stephdust/ESP32-PoolMaster-SD/docs/InsideBox.png

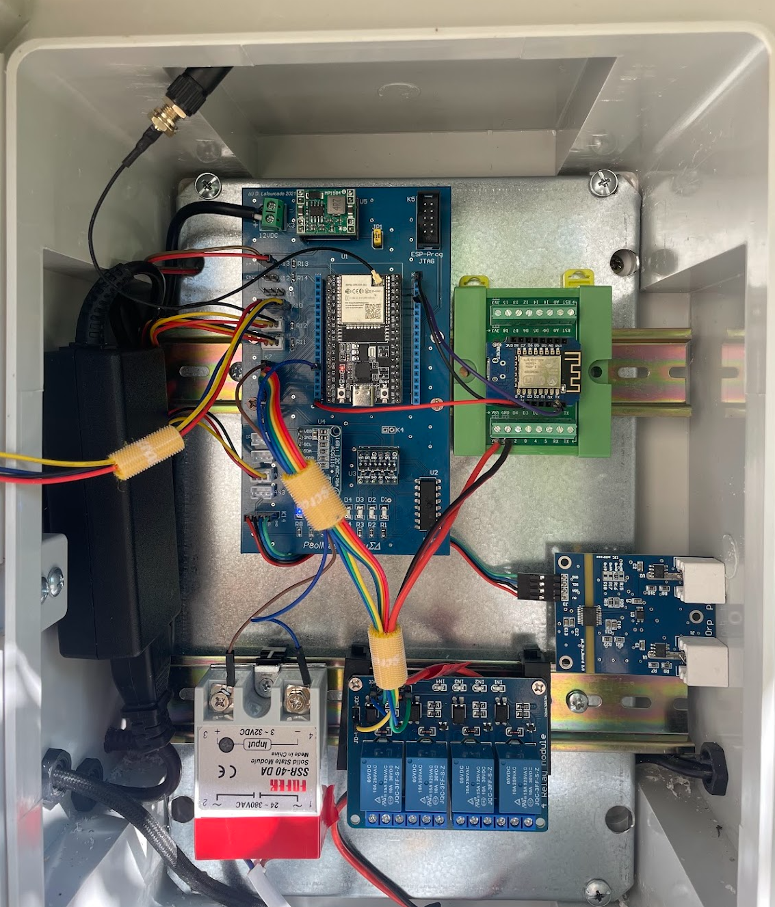
docs/InsideBox.png
