stephdust/ESP32-PoolMaster-SD/Nextion/PoolMaster_Nextion_V5.0/Page_Home.png

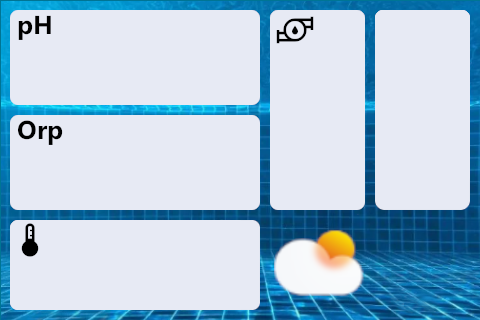
Nextion/PoolMaster_Nextion_V5.0/Page_Home.png
