stephdust/ESP32-PoolMaster-SD/Nextion/PoolMaster_Nextion_V5.0/Page_Settings_INACTIVE.png

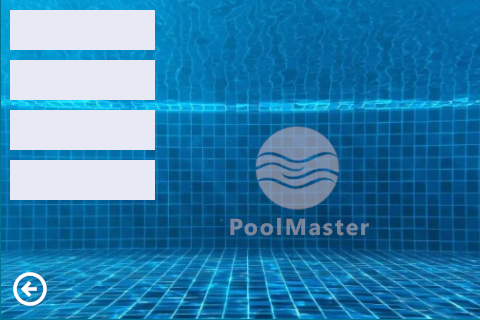
Nextion/PoolMaster_Nextion_V5.0/Page_Settings_INACTIVE.png
