stephdust/ESP32-PoolMaster-SD/PCB/Bill of Materials-PoolMaster.xlsx

Comment | Description | Designator | Footprint | LibRef | Quantity
HEADER 3 |  | AN0, AN1, AN2, AN3 | JST-1X3 | HEADER 3 | 4
100n | Capacitor | C1 | 0805C-GENERIC | CAP | 1
Red |  | D1, D2, D3, D4 | TOPLED-RED | LED | 4
Green |  | D5, D6 | TOPLED-GREEN | LED | 2
Yellow |  | D7 | TOPLED-YELLOW | LED | 1
Blue |  | D8 | TOPLED-BLUE | LED | 1
U/L | Jumper | JP1 | 2_PADS | JUMPER | 1
Header 19 | Header, 19-Pin | K1, K2 | HDR1X19 | Header 19 | 2
12VDC | Header, 2-Pin | K3 | MKDS15_2RMI | Header 2 | 1
I2C | Header, 2-Pin | K4 | HEADER-1X2 | Header 2 | 1
ESP-Prog/JTAG | Header, 5-Pin, Dual row | K5 | HE10_10 | Header 5X2 | 1
HEADER 3 |  | K6 | HEADER-1X3 | HEADER 3 | 1
HEADER 6 |  | K7 | HEADER-1X6 | HEADER 6 | 1
Air T | Header, 3-Pin | K8 | JST-1X3 | Header 3 | 1
Water T | Header, 3-Pin | K9 | JST-1X3 | Header 3 | 1
Display | Header, 4-Pin | K10 | HEADER-1X4 | Header 4 | 1
Buzzer | Header, 3-Pin | K11 | HEADER-1X3 | Header 3 | 1
Chl LVL | Header, 2-Pin | K12 | HEADER-1X2 | Header 2 | 1
pH LVL | Header, 2-Pin | K13 | HEADER-1X2 | Header 2 | 1
I2C-5V | Header, 4-Pin | K14 | HEADER-1X4 | Header 4 | 1
3k3 | Resistor | R1, R2, R3, R4, R5, R6, R7, R8 | 0805R-3K3 | RES2 | 8
10k | Resistor | R11, R12, R13, R14 | 0805R-10K | RES2 | 4
ESP32-DEVKITC-32E | - Transceiver; 802.11 b/g/n _Wi-Fi, WiFi, WLAN_, BluetoothÂ® Smart Ready 4.x Dual Mode For Use With ESP-WROOM-32 | U1 | MODULE_ESP32-DEVKITC-32D | ESP32-DEVKITC-32D | 1
PCF8574AN | Remote 8-Bit I/O Expander for I2C-Bus, 2.5 to 6 V, -40 to 85 degC, 16-pin PDIP (N), Pb-Free (RoHS) | U2 | DIP16 | PCF8574AN | 1
SHIFTER 4CH |  | U3 | SHIFTER 4CH | SHIFTER 4CH | 1
ADS1115 |  | U4 | ADS1115 Module | ADS1115 | 1
MP1584EN |  | U5 | MP1884EN | MP1584EN | 1
