stephdust/ESP32-PoolMaster-SD/PCB/BOM.xlsx

Sheet: Feuil1
Objet | lien | Prix Unitaire | Quantité | Prix Total
1 Alimentation MeanWell 12V HDR-30 | https://fr.aliexpress.com/item/4000512714343.html?spm=a2g0s.9042311.0.0.27426c372DwVi7 | 16 | 1 | 16
1 carte fille mega 2560 DIY + connecteur |  | 5 | 1 | 5
cables dupont 30cm | https://fr.aliexpress.com/item/32987024879.html?spm=a2g0s.9042311.0.0.6d836c373sh99I | 3 | 2 | 6
cable PH2.0 dupont | https://fr.aliexpress.com/item/4000983636722.html?spm=a2g0s.9042311.0.0.6d836c373sh99I | 5 | 1 | 5
mega2560 R3 Advanced Keyestudio | https://fr.aliexpress.com/item/32902050141.html?spm=a2g0s.9042311.0.0.27426c37zPn488 | 13 | 1 | 13
W5100 Ethernet Shield Keyestudio | https://fr.aliexpress.com/item/2042247327.html?spm=a2g0s.9042311.0.0.27426c37zPn488 | 8 | 1 | 8
Nextion bordure 6 | https://fr.aliexpress.com/item/4000127982680.html?spm=a2g0s.9042311.0.0.27426c37zPn488 | 6 | 1 | 6
Nextion NX4832K035 | https://fr.aliexpress.com/item/4000127982680.html?spm=a2g0s.9042311.0.0.27426c37zPn488 | 33.59 | 1 | 33.59
DS3231 Clock | https://fr.aliexpress.com/item/33000531103.html?spm=a2g0s.9042311.0.0.27426c37PumqU7 | 3 | 1 | 3
Support Rail DIN plastique | https://fr.aliexpress.com/item/4000539460290.html?spm=a2g0s.9042311.0.0.27426c37PumqU7 | 1.37 | 1 | 1.37
Relay shield | https://fr.aliexpress.com/item/33050594625.html?spm=a2g0s.9042311.0.0.27426c37PumqU7 | 5.7 | 1 | 5.7
Rail din 20cm | https://fr.aliexpress.com/item/32903957266.html?spm=a2g0s.9042311.0.0.27426c3755H1y5 | 2 | 2 | 4
sonde pression | https://fr.aliexpress.com/item/32851667666.html?spm=a2g0s.9042311.0.0.27426c3755H1y5 | 11 | 1 | 11
Connecteur RJ45 | https://fr.aliexpress.com/item/32901871650.html?spm=a2g0s.9042311.0.0.27426c37qMQp8c | 7 | 1 | 6
boitier legrand Marina | ebay | 60 | 1 | 60
tole galvanisé 300x200 | ebay | 11 | 1 | 11
pompe peristatique PR4 SEKO | ebay | 130 | 2 | 260
sonde PH Hanna |  | 70 | 1 | 70
Sonde ORP |  | 70 | 1 | 70
sonde temperature DS18B20 | https://fr.aliexpress.com/item/32983291667.html | 7.54 | 1 | 7.54
Module d'isolation de signal DFR0504 | https://www.gotronic.fr/art-module-d-isolation-de-signal-dfr0504-27832.htm | 21.9 | 2 | 44
Adaptateur pH/ORP 1130 | https://www.gotronic.fr/art-adaptateur-ph-orp-1130-12112.htm | 30.5 | 2 | 71
2 Relay de puissance 2P 25A 2NO 220V | https://fr.aliexpress.com/item/4000198627842.html?spm=a2g0s.9042311.0.0.27426c37qVlc3P | 6.68 | 2 | 13
(commande Lumiere + electrovanne )
Disjoncteur C2 |  | 15 | 1 | 15
1 kit mise à la terre poolterre |  | 50 | 1 | 50
accessoires divers |  | 20 | 1 | 20
 |  |  | total | 815.2

Sheet: Feuil2
Water pressure probe 500 kPa (5 bar) | https://fr.aliexpress.com/item/32851667666.html?spm=a2g0s.9042311.0.0.221a6c37pnW82C | 10.54 €
Power supply 12V-2A Meanwell | https://fr.aliexpress.com/item/4000512714343.html?spm=a2g0s.9042311.0.0.221a6c37pnW82C | 16.58 €
T 1/4" pipe connector | https://fr.aliexpress.com/item/4000195262654.html?spm=a2g0s.9042311.0.0.221a6c37pnW82C | 3.78 €
DIN rail alu 2x25cm | https://fr.aliexpress.com/item/4000126680453.html?spm=a2g0s.9042311.0.0.221a6c37pnW82C | 3.82 €
5x2 PCB DIN supports | https://fr.aliexpress.com/item/4000505427059.html?spm=a2g0s.9042311.0.0.221a6c37pnW82C | 4.83 €
Active Buzzer x3 | https://fr.aliexpress.com/item/32849730395.html?spm=a2g0s.9042311.0.0.221a6c37pnW82C | 1.66 €
Bidirectionnal Level Shifter | https://fr.aliexpress.com/item/32849730395.html?spm=a2g0s.9042311.0.0.221a6c37pnW82C | 0.20 € | note: use small diameter header pins (PCB has small holes)
6x5V relays module | https://fr.aliexpress.com/item/32649659086.html?spm=a2g0s.9042311.0.0.221a6c37pnW82C | 5.24 €
ADC 4 chanels 16bits | https://fr.aliexpress.com/item/32817162654.html?spm=a2g0s.9042311.0.0.221a6c37pnW82C | 1.82 €
ESP32-DevKitC-32E (V4) | https://fr.aliexpress.com/item/4001283141906.html?spm=a2g0s.9042311.0.0.221a6c37pnW82C | 10.13 €
LEDs 1206 5x100pc | https://fr.aliexpress.com/item/4000927747306.html?spm=a2g0s.9042311.0.0.27426c37BAGaMu | 1.91 €
Air temperature probe - DS18B20 3m | https://fr.aliexpress.com/item/4000895660165.html?spm=a2g0s.9042311.0.0.27426c37BAGaMu | 1.62 €
JST connectors | JST-1x3 M (2 mm pitch)
All resistors and capacitors | Size 0805
Converter DC-DC LM2596 x5 | https://fr.aliexpress.com/item/32531438467.html?spm=a2g0s.9042311.0.0.1ec66c37Lne6Zz | 4.03 € | note: use small diameter header pins (PCB has small holes)
Nextion display frame | https://fr.aliexpress.com/item/4000127982680.html?spm=a2g0s.9042311.0.0.1ec66c37Lne6Zz | 5.60 €
Display Nextion Enhanced NX4832K035 | https://www.banggood.com/fr/Nextion-Enhanced-NX4832K035-3_5-Inch-HMI-Intelligent-Smart-USART-UART-Serial-Touch-Screen-TFT-LCD-Module-p-1188732.html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 | 30.42 €
Amplifier pH-ORP 1130 x2 | https://www.gotronic.fr/art-adaptateur-ph-orp-1130-12112.htm | 109.30 €
Signal isolation module DFR0504 x2 | https://www.gotronic.fr/art-module-d-isolation-de-signal-dfr0504-27832.htm
Microdos pH probe | https://www.my-pool-covers.com/fr/regulation-chloreph/77-sonde-ph-dosage-automatique-piscine.html | 60.00 €
Microdos Redox probe | https://www.my-pool-covers.com/fr/regulation-chloreph/78-sonde-ph-dosage-automatique-piscine.html | 66.55 €
Analyze room (double) | https://www.my-pool-covers.com/fr/home/81-chambre-d-analyse-pour-sonde-ph-ou-redox.html | 129.00 €
Chlorine calibration solution 650mV | https://www.my-pool-covers.com/fr/accessoires-dosage/105-solution-etalon-pour-calibration-chlore-650-mv.html | 9.50 €
Chlorine calibration solution 468mV | https://www.my-pool-covers.com/fr/accessoires-dosage/106-solution-etalon-pour-calibration-chlore-468-mv.html | 9.50 €
pH calibration solution pH 7 | https://www.my-pool-covers.com/fr/accessoires-dosage/107-solution-etalon-pour-calibration-ph-7.html | 8.00 €
pH calibration solution pH 4 | https://www.my-pool-covers.com/fr/accessoires-dosage/108-solution-etalon-pour-calibration-ph-4.html | 8.00 €
Support collar 50mm 1/2" x2 | https://www.my-pool-covers.com/fr/regulation-chloreph/119-collier-de-prise-en-charge-50mm.html | 19.00 €
Pool grounding 50mm | https://www.my-pool-covers.com/fr/regulation-chloreph/121-pool-terre-50mm.html | 34.50 €
Microdos peristaltic pump 1,5l/h x2 | https://www.my-pool-covers.com/fr/regulation-chloreph/149-pompe-doseuse-peristaltique-avec-reglage-de-debit-15lh.html | 176.00 €
ABS case 350x250x150mm | https://www.amazon.fr/gp/product/B07C7X9K5R/ref=ppx_yo_dt_b_asin_title_o00_s00?ie=UTF8&psc=1 | 41.45 €
 |  | 772.98 €
