stephdust/ESP32-PoolMaster-SD/docs/PoolMaster_FullLogic.pdf

HistoryStats | StatusLights | MeasuresPublish

## SettingsPublish

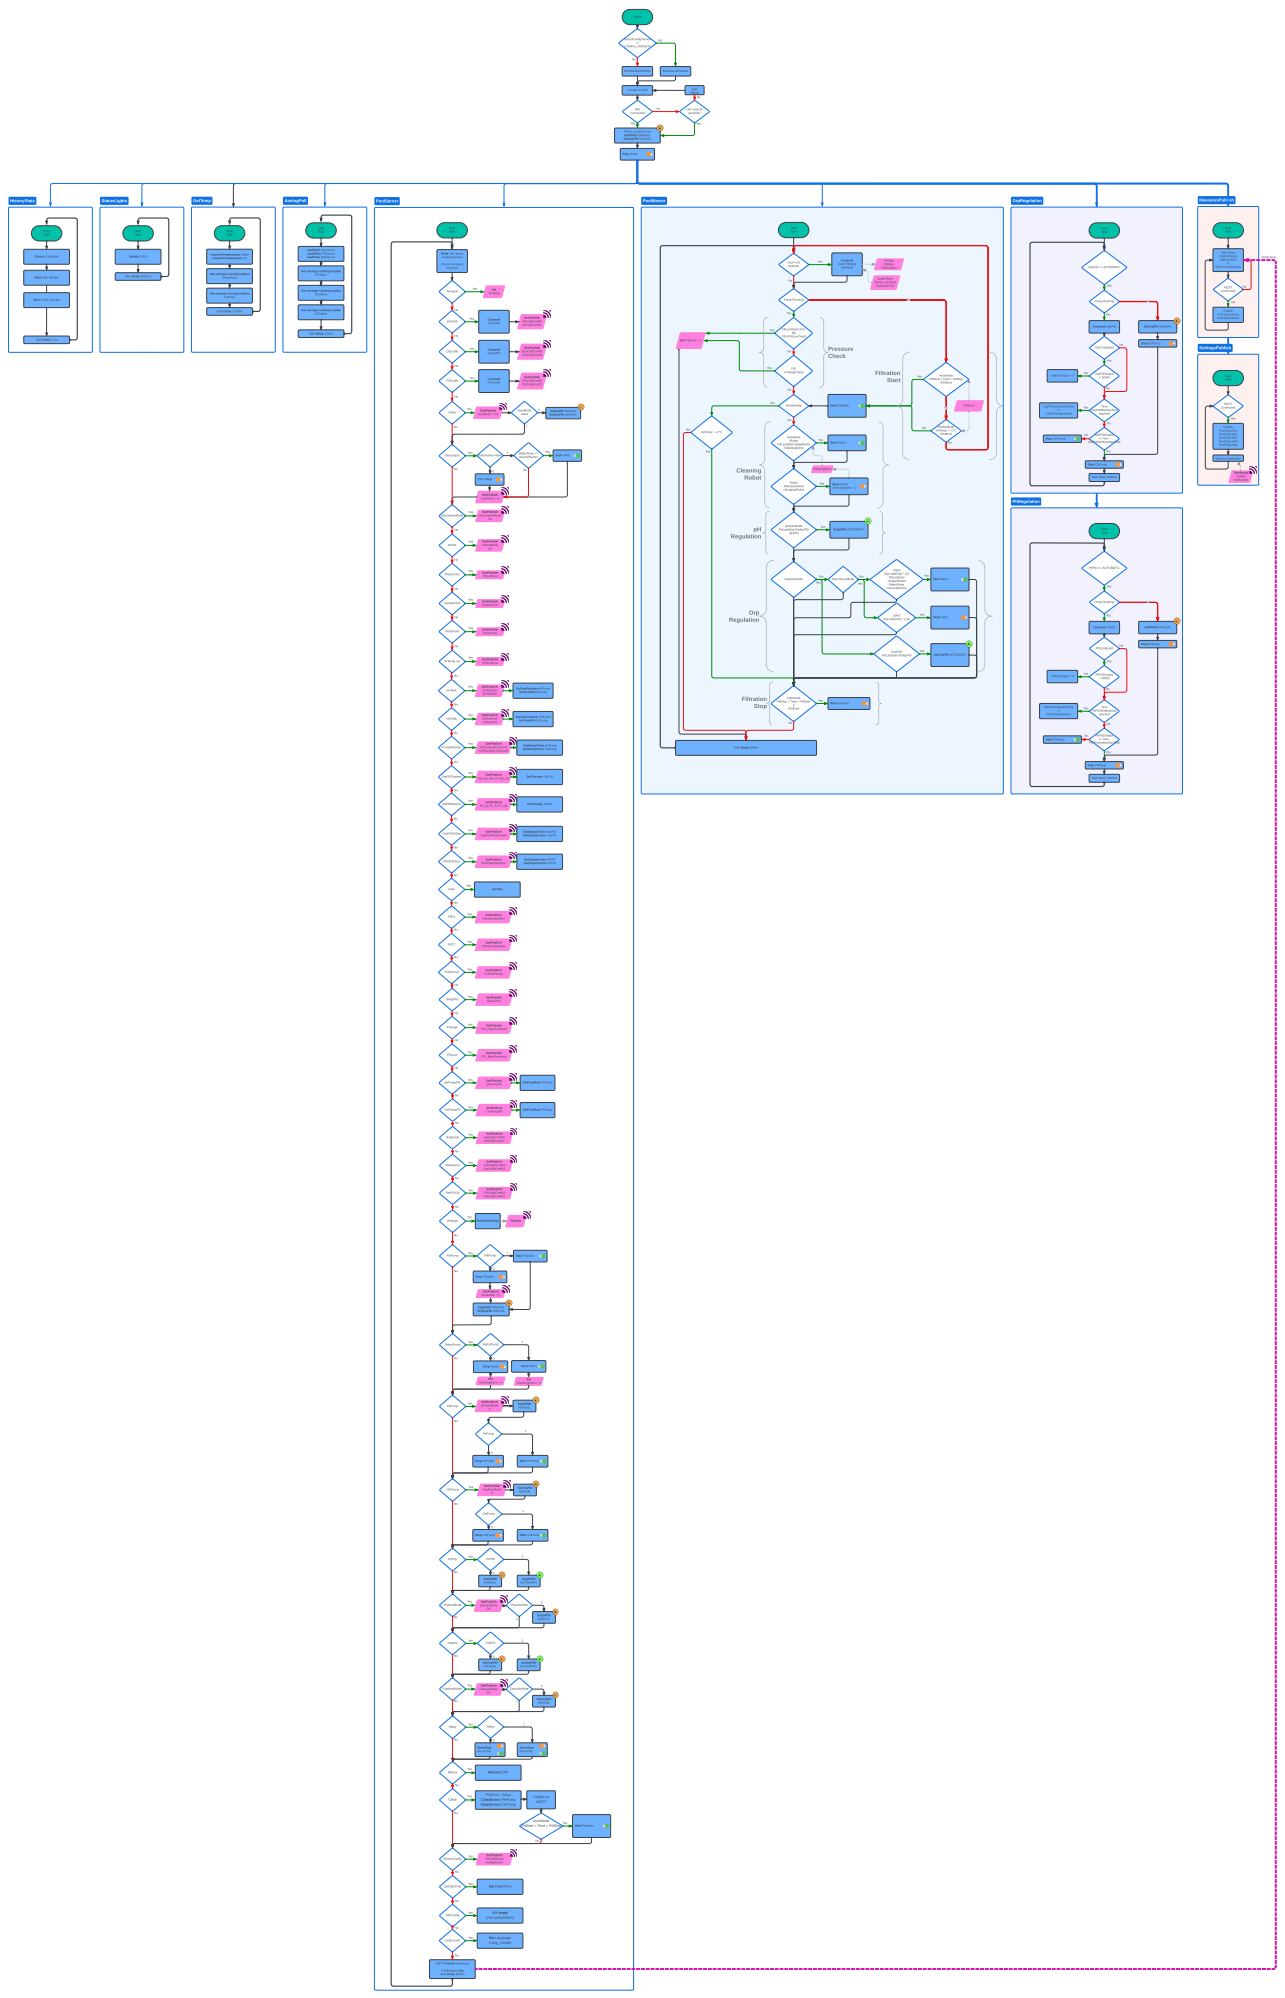
[picture p13: page 1]
PoolServer; PoolMaster; OrpRegulation; PhRegulation; Start Task; GetTemp; AnalogPoll; hour==15; (hottest); Yes; Start Filtration; !pHPID; OrpAutoMode; ElectrolyseMode Yes; !SWG; Orp<SetPoint * 0.9 FiltLastStart >DelayElectro WaterTemp >SecureElectro; Start SWG; SWG; Orp>SetPoint * 1.05; !OrpPID; FiltLastStart>DelayPID; SetOrpPID AUTOMATIC; || PSIError; Stop Filtration; WinterMode Yes; WinterMode AirTemp < -2°C; FiltLastStart>2mn &&; Task Delay 500ms; PSIError; keyword; TempExt; Set AirTemp Yes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

Yes PhPID & OrpPID Init SetPhPID MANUAL SetOrpPID MANUAL Stop Robot

requestTemperatures Water
requestTemperatures Air Get average running median WaterTemp Get average running median AirTemp Task Delay 1000ms

readFilter OrpSensor
readFilter PhSensor
readFilter PSISensor Get average running median PhValue Get average running median OrpValue Get average running median PSIValue

Read and parse
receiving queue Check command

Task Delay PublishPeriod

Store pH Sample

Compute Auto Filtering Schedule

FiltStart FiltStop FiltDuration

(default 30s) or Wait for Notification MQTT Connected

Store Orp Sample

WaterTemp TempLowThresh TempSetPoint

Store Temp Sample

Pump Running Yes

PSI<PSILowTresh Yes

Task Delay 2 mn

PSI >PSIHighTresh No

AutoMode FiltStart < Time < FiltStop

!PSIError Yes No

AutoMode
!Robot FiltLastStart>DelayRobot

No Start ChlPump

OrpPIDOutput <= now - OrpPIDwindowStartTime

Wait for Notification

Robot RobotLastStart >DurationRobot

TaskNotify Publish Notification

Set/Publish AutoMode = 0

Stop Robot CleaningDone = 1

Set/Publish ElectrolyseMode
1/0 Yes

pHAutoMode FiltLastStart>DelayPID

Set/Publish WTempLow

AutoMode FiltStop < Time < FiltStart

PhPIDOutput <= now - PhPIDwindowStartTime

SetpHPID MANUAL SetOrpPID MANUAL

Set/Publish OrpAutoMode

Publish to MQTT

Set Date/Time

(new parameters) No

MQTT Publish Measures Confirmation Bip Task Delay 500ms
