stephdust/ESP32-PoolMaster-SD/include/Helpers.h

#ifndef POOLMASTER_HELPERS_H
#define POOLMASTER_HELPERS_H

#include "PoolMaster.h"

void remove_duplicates_slash(char*);
void simpLinReg(float * , float * , double & , double &, int );

class Helpers {
  public:
    static uint8_t count_items(const char * const ** list);
    static uint8_t count_items(const char * const * list);

    static const char * translated_word(const char * const * strings, uint8_t language_index);
};


#endif
