stephdust/ESP32-PoolMaster-SD/include/HistoryStats.h

#ifndef POOLMASTER_DATA_H
#define POOLMASTER_DATA_H

#include <Arduino.h>
#include <CircularBuffer.hpp>
#include "Config.h"
#include "PoolMaster.h"

#define NUMBER_OF_HISTORY_SAMPLES   360
#define GRAPH_Y_SIZE                200 // 200 vertical values


// Used for tasks
void stack_mon(UBaseType_t&);

// RTOS Task
void HistoryStats(void *);

#endif
