stephdust/ESP32-PoolMaster-SD/(commit log)

2024-07-01 Update PoolMaster_ModifiedMay2024.HMI
    Increased size of active region for PID and ph Orp values.
2024-09-10 Added support for Electrolyser
    Added support for Electrolyser as a pump
2024-09-24 New version 3.4
    New version 3.4
    - Added Electrolyser/Salt Water Chlorine Generator support
    - Added a relay class for better relay handling
2024-09-24 Moved Pump Filter Mode to config
2024-10-03 New version supporting Relay and Pump classes
2024-10-09 Corrected nullptr and constructor of class Pump & Relay. Updated Nextion file (remove String usage)
    [Config.h.template.h, Loops.cpp, Nextion.cpp, Setup.cpp]
2024-10-09 Remove Include DebugUtils.h from Relay and Pump header files.
2024-10-16 Created flow chart for PoolMaster Logic
2024-10-16 Added Flowchart
2024-11-08 HMI & New Logic
    Redesigned Nextion HMI
    Reviewed the logic in PoolMaster.cpp
    [PoolMaster.cpp, PoolMaster.h, PoolServer.cpp, Setup.cpp]
2025-01-09 Reduced Verbosity of temperature measurement
2025-01-09 New extended board
2025-01-10 Added pool level PIN
2025-01-15 Nextion latest version
    [SplashAccelerationCurve.xlsx]
2025-01-16 Update Nextion
    [SplashAccelerationCurve.xlsx]
2025-03-12 New Version v5.6
    [LocaleManagement.xlsx]
2025-04-01 Added Spare and Robot in switches page
2025-04-02 Minor Changes
    - Page change animation on home page to make it more natural
    - Reboot and Debug options in Info page
    - Moved DEVT directive from Config.h to platformio flags
    [Config.h, Nextion.cpp, PoolServer.cpp, translation.h]
2025-04-04 Corrected bug with Chlorine tank fill button
    [Nextion.cpp]
2025-04-07 Create Gerber_5.zip
    Added precabling for ports 13 & 23 to use for chlorinator and pool fill valve
2025-04-07 Updated with Pool Fill Pump
2025-04-08 Added Features
    - SMTP configurable for Email alerts
    - Uptime indication
    - Ability to activate or deactive buzzer by software {Buzzer:0/1}
    - Added pool fill feature with minimum and maximum fill in pump runtime
    [Config.h, Config.h.template.h, Loops.cpp, Nextion.cpp, Nextion.h, PoolMaster.cpp, PoolMaster.h, PoolServer.cpp]
2025-04-09 Bug Correction
    Max length of preferences key was reached. Corrected.
    [Loops.cpp, PoolMaster.cpp, PoolServer.cpp, Setup.cpp]
2025-04-19 1st clean
    [BOM.xlsx, Bill of Materials-PoolMaster.xlsx]
2025-04-19 changing and deleting files
    [BOM.xlsx, Bill of Materials-PoolMaster.xlsx]
2025-04-19 add BMS68x lib
2025-04-20 Enable runtime PIN reconfiguration
2025-04-20 Added PIN reconfiguration page
2025-04-20 Added MQTT Topic configuration and PIN assignment
2025-04-24 new Gerber
    [ProPrj_PCB_PoolMaster_Addons_2025-04-24 (1).epro, ProPrj_PCB_PoolMaster_Addons_2025-04-24.epro]
2025-04-25 New PCB design
    Added
    - ESP32 unused ports for future use
    - 4 I2C ports for additional components
    - Nextion power off circuit in case reboot is needed
2025-04-28 I2C and Ports extended output
2025-05-02 Corrected a bug in pump config table definition
    This bug prevented the logic to work normally. In case of new config version number, the pumps config table was not initialled correctly.
    [Setup.cpp]
2025-05-02 Removed Relay.h inclusion as already included in Pump.h
2025-05-06 Added function to set NextionLibrary object at a later stage. Not in constructor
2025-05-07 Add test not to crash in case submenu is not properly defined
2025-05-07 Bug correction which prevented MainMenu and SubMenu variables to be properly defined
    [Nextion.cpp, Nextion_Menu.cpp, Nextion_Menu.h]
2025-05-12 New extensions + compil fix
    [Extension_BME680_0x77.cpp, Extension_Ports.cpp, Extension_TFA-Venice_RF433T.cpp, Extension_WaterMeterPulse.cpp]
